jbocinsky/PortalTurret/Final Design Review.pdf

# EEL 4924 Senior Design

# Project: Glorious Freedom

# Team: Aperture Laboratories

## Submitted by:

## James Bocinsky (CE) and Mason Rawson (CE)

Abstract:

James Bocinsky and Mason Rawson, both CE majors, will be pairing up as a team to create an autonomous turret. The primary subsystems of the project will include a battery power supply, a camera, a central processing controller, and pan-tilt mounted nerf guns. The brain will use opencv with face detection to track an object’s motion. Software will calculate where and when to shoot nerf guns based on current object movement. We also have a manual override remote controller using wifi communication that allows a user to aim and shoot the turrets.

Features:

The overall goal of the glorious freedom sentry is to autonomously track an object and fire nerf guns at it. The project is inspired by the autonomous sentry turrets from the game “portal”, and the team will stick to this theme throughout the project. There will be one sentry (the overall shooting system) which has two turrets. Each turret has an independently controlled and aimed nerf gun.
The sentry will have two modes of operation, an autonomous mode and a manual mode. During autonomous mode, the sentry will be controlled by image processing via OpenCV. The image processing system, a raspberry pi 3 (pi), will use video input from our camera to the OpenCV library to pick out an object from a still background. The pi will then use SPI to send the objects pixel location to the main board. The main board will then translate the current object's location to motor positions for each turret. Once the position translation has been calculated, each turret will aim at the object and fire it’s nerf gun if the object is no longer moving.
During manual mode, the turret will be able to be controlled by a human using a separate controller. The controller will have input from buttons and a joystick. The joystick will control where the nerf guns point. Buttons will control commands and state. The button commands are shoot left nerf gun, shoot right nerf gun, shoot both nerf guns, reset aiming position, and toggle the mode of operation. The commands and joystick information will be sent to the main board on the sentry via a wifi module. Once the sentry has received the information it will operate as a user should expect; moving the sentries according to the joystick and firing the nerf guns according to a corresponding button press.

Technology Selection:

Our goal was to minimize mechanical work and custom electrical subsystems by using off-the-shelf parts. This would allow us to pursue advanced embedded computing with plenty of room to grow within the embedded computing.
To minimize mechanical and custom electrical work we took various steps. First we bought pan tilt mounts instead of 3D printed custom mounts. We will also use a USB camera to simplify this interface. The pi was chosen for video input as it was OpenCV friendly and powerful enough to handle the library. This allowed us to focus on the controls aspect of the project on the main board over configuring and setting up opencv on a raw barebones microcontroller. We took apart and used DC motors from an electric nerf gun instead of creating one from scratch. Our main board, using an msp432 and supporting an ESP8266, had very minimal analog components to allow us to focus on the controls and software aspects of the project. The controller board had an msp432 as well to keep things consistent across the project. It supported an ESP8266 as well for wifi communication, a joystick and buttons for human interactivity.
For software we utilized python for OpenCV, lua scripts for the ESP8266, C and C++ for our on board processing and controls. We used the openCV library, the most commonly used free computer vision software to assist in our face detection.
Technology: | Quantity:
Steppers and Drivers | 2
Metal Pan Tilt Mounts | 2
Nerf Guns | 2
Camera | 2
Raspberry Pi 3 | 1
Joystick | 1
Buttons | 6
ESP8266 NodeMCU Wifi Module | 2
MSP432 | 2

4.5V Battery Pack | 1
Lithium Polymer Battery 7.4V | 1
Portable USB Battery Charger | 1
6 Bullet Ammo Clip | 2
Voltage Regulator | 4
Buck Converter | 1
Various Resistors (see schematic for values) | x
Various Capacitors (see schematic for values) | x

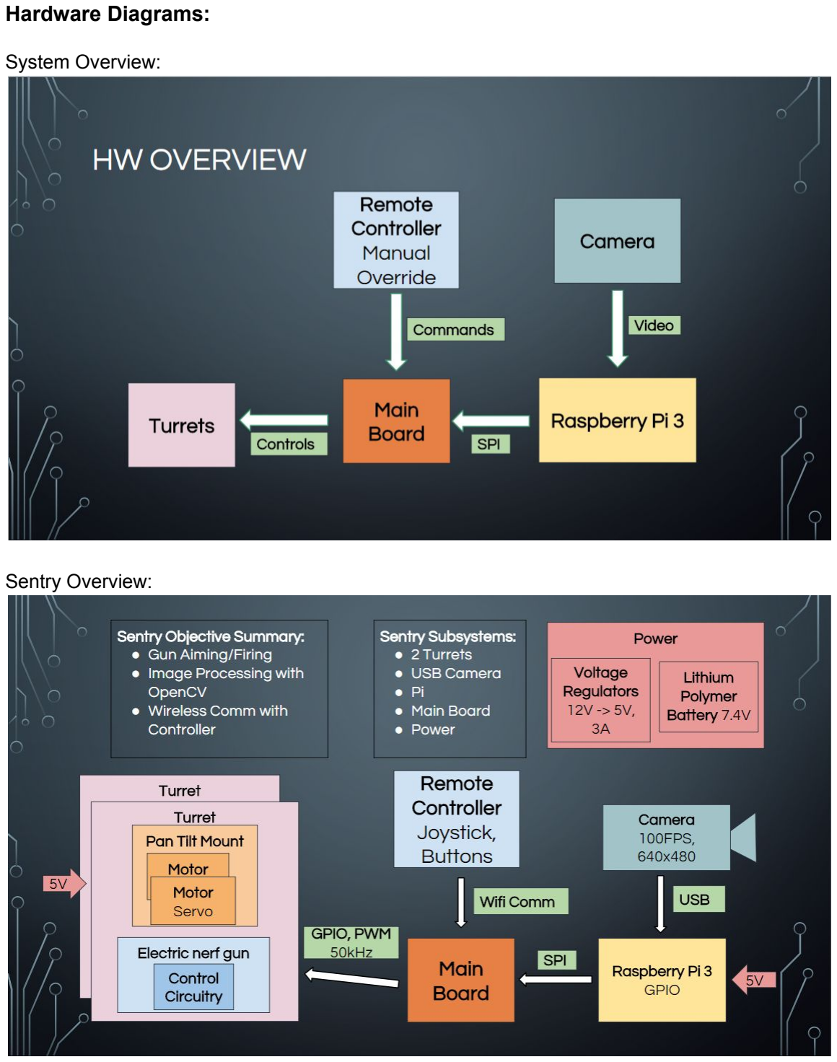
[picture p2: page 5]

Hardware Diagrams:

System Overview:

Sentry Overview:

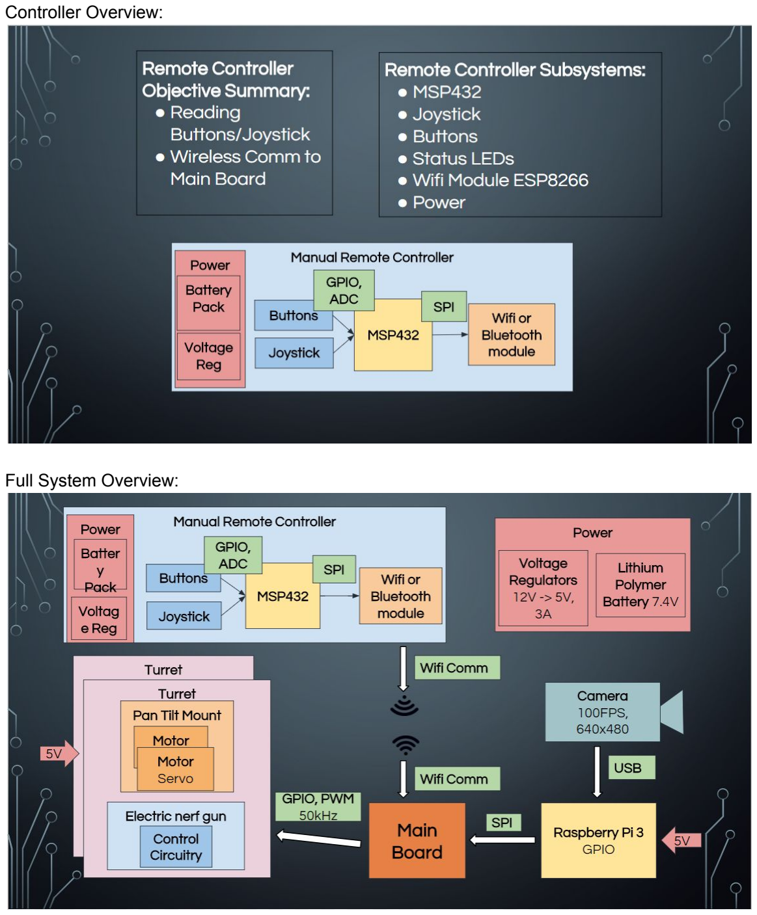
[picture p3: page 6]

Controller Overview:

Full System Overview:

Schematics:
Main Board:

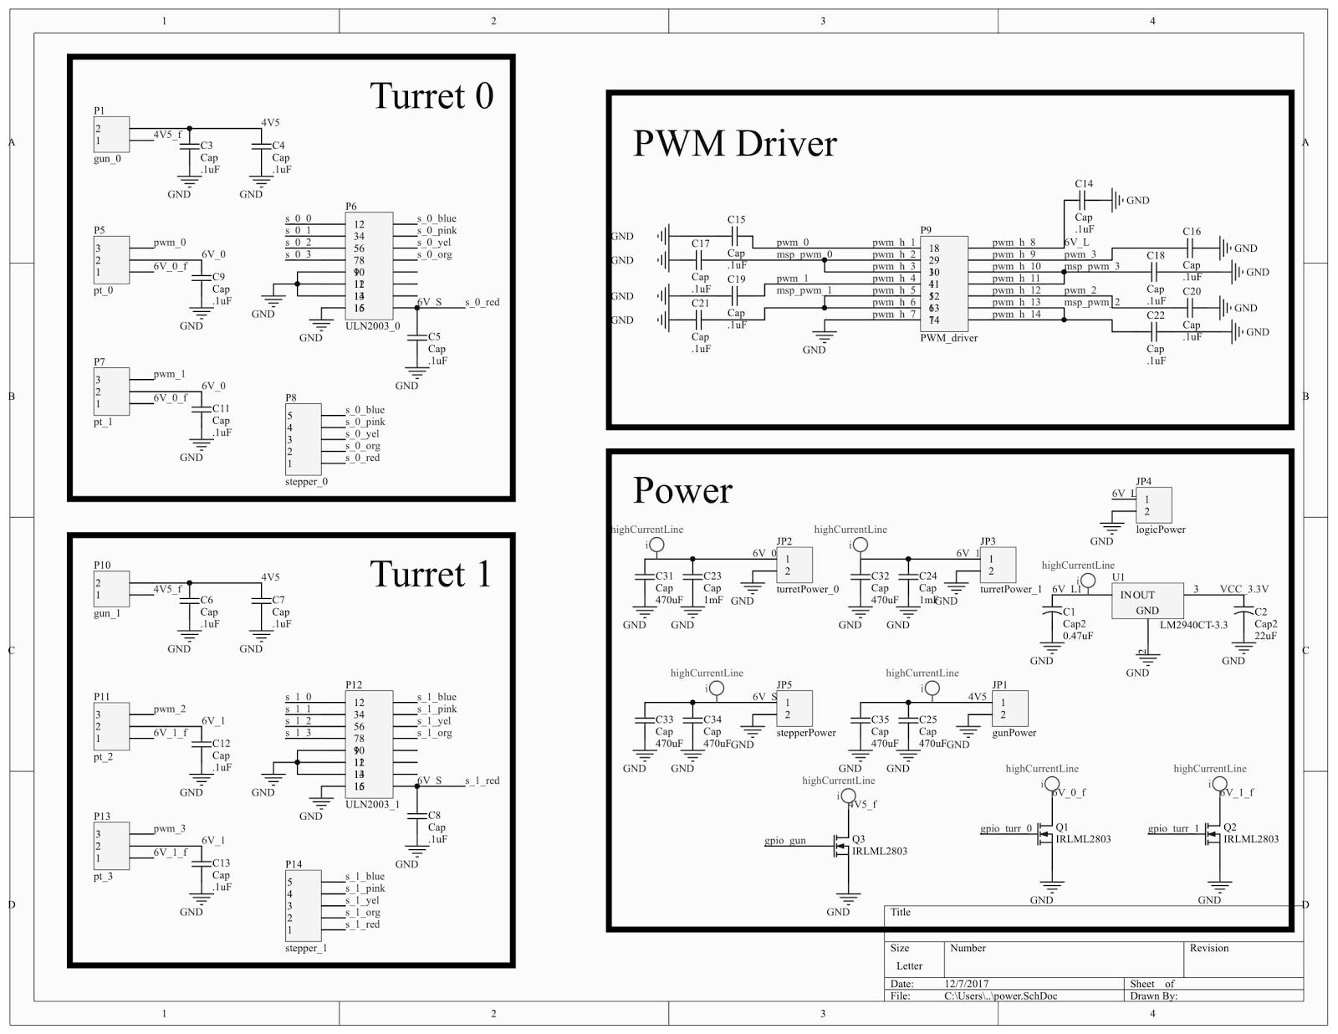
[picture p4: figure]

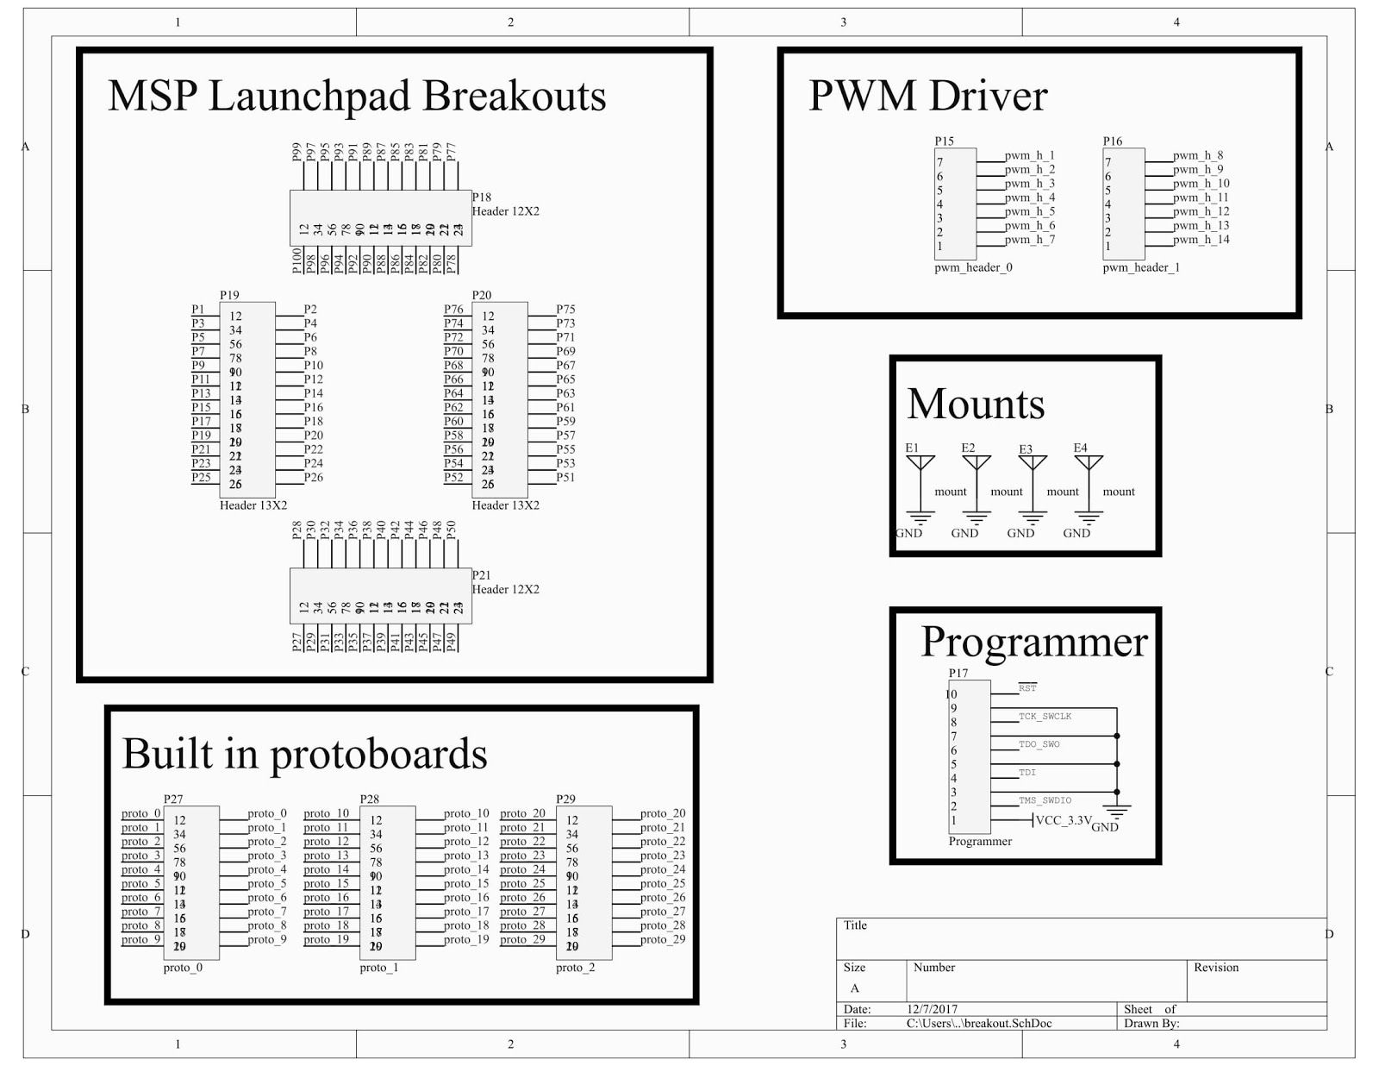
[picture p5: figure]

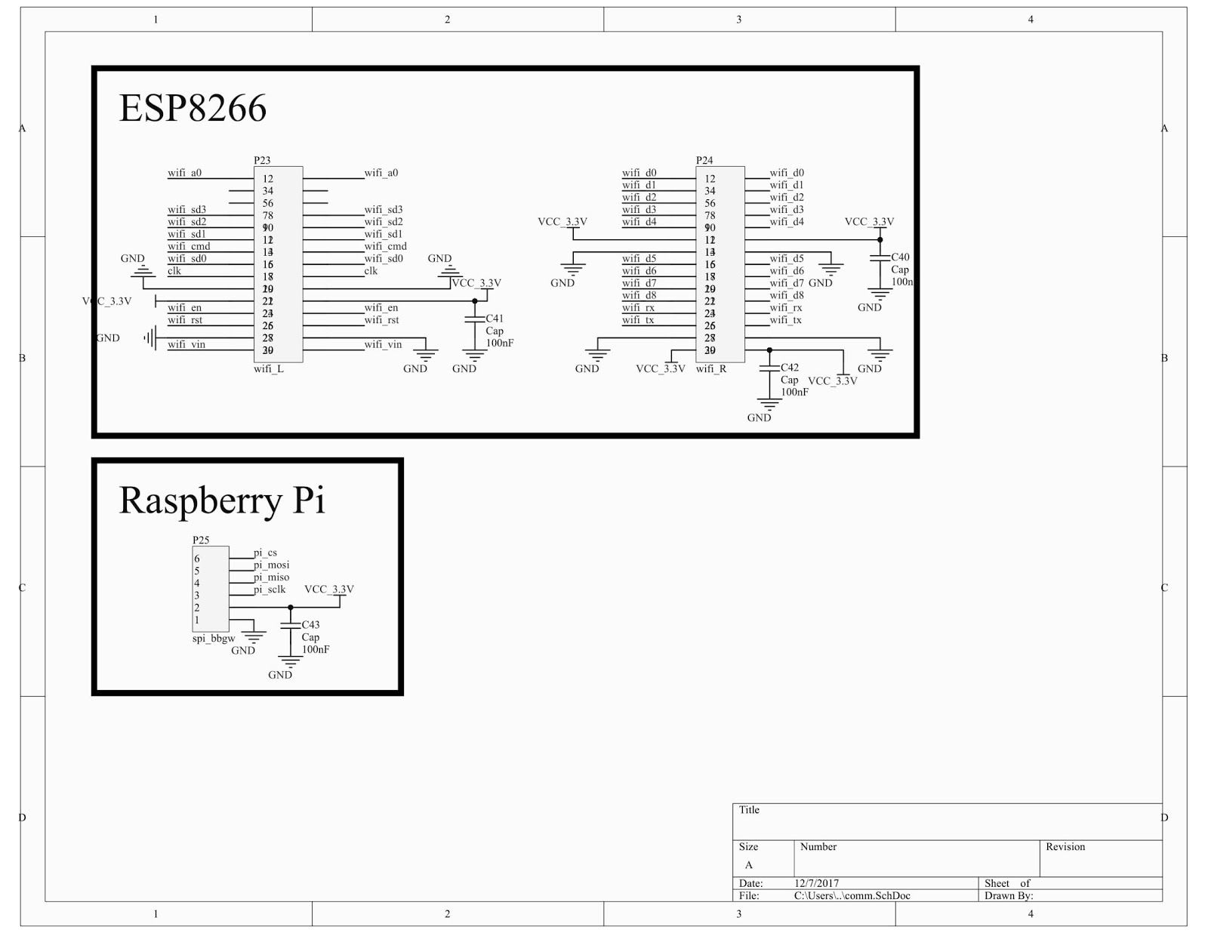
[picture p6: figure]

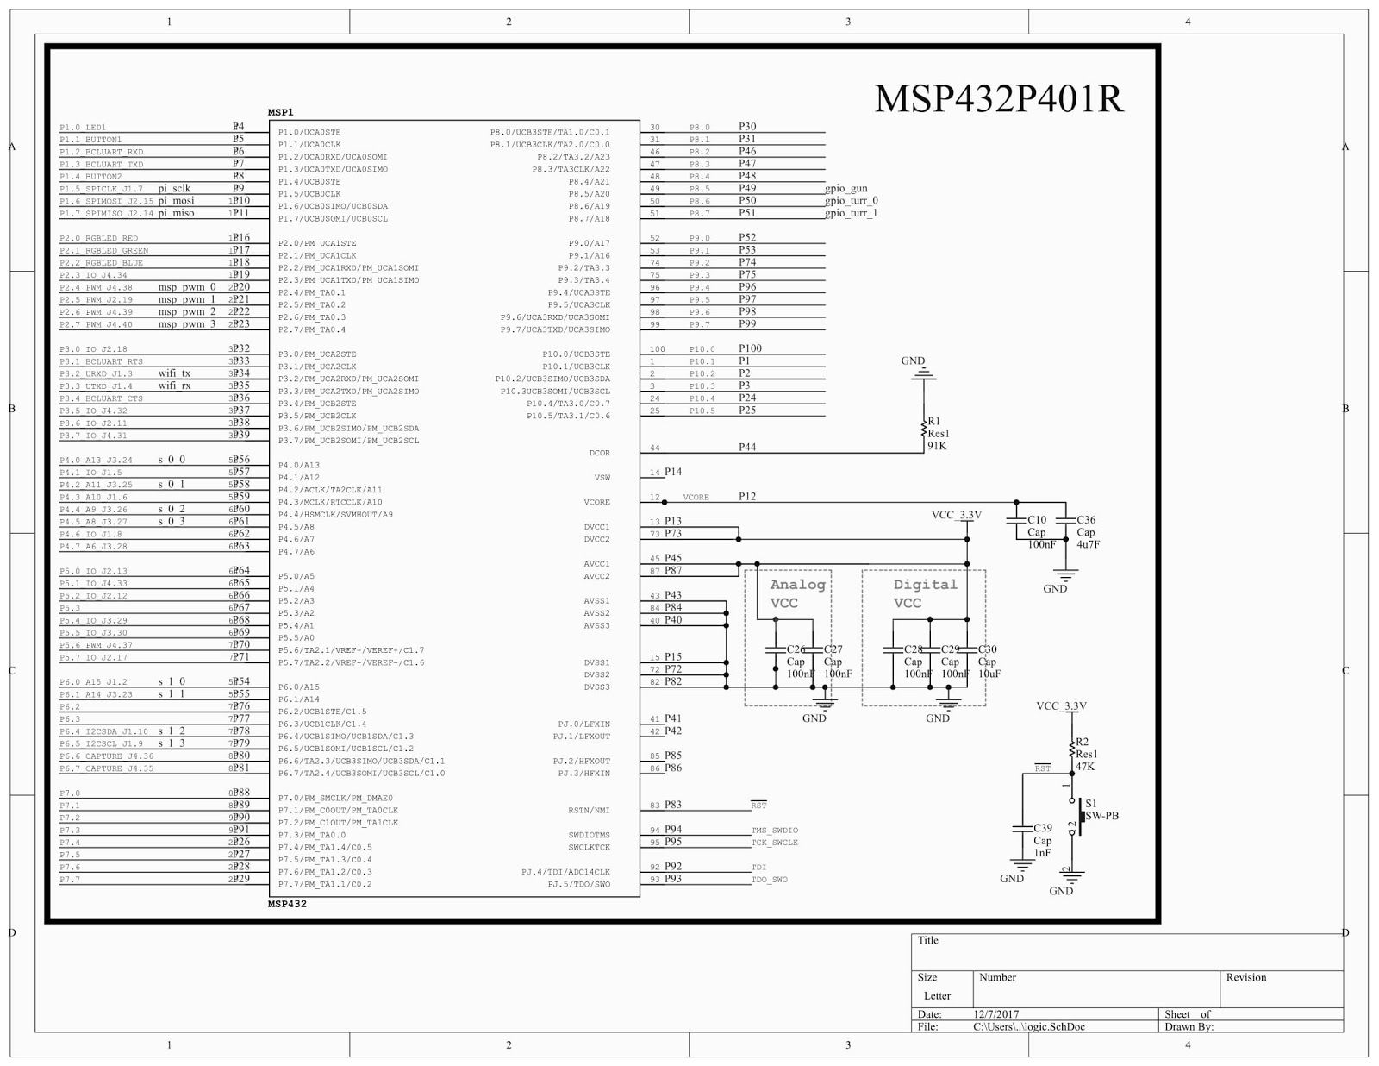
[picture p7: figure]

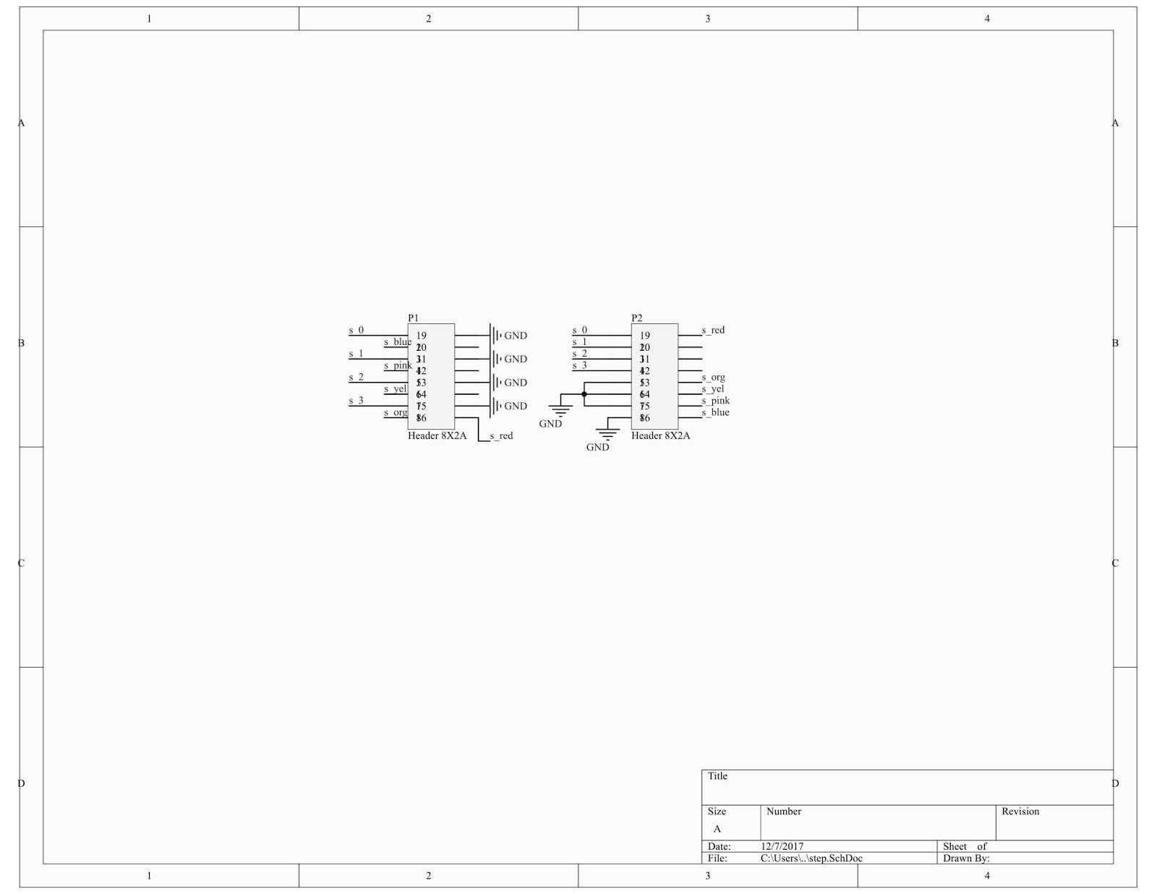
[picture p8: figure]

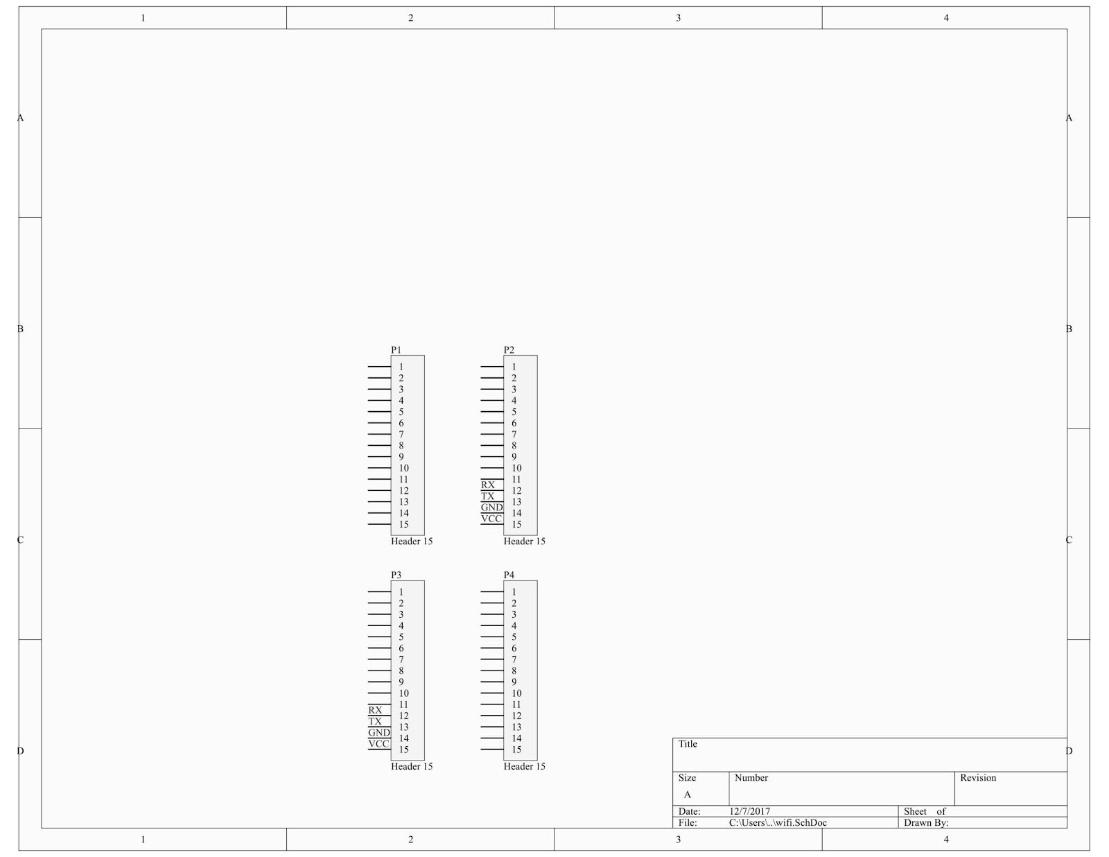
[picture p9: figure]

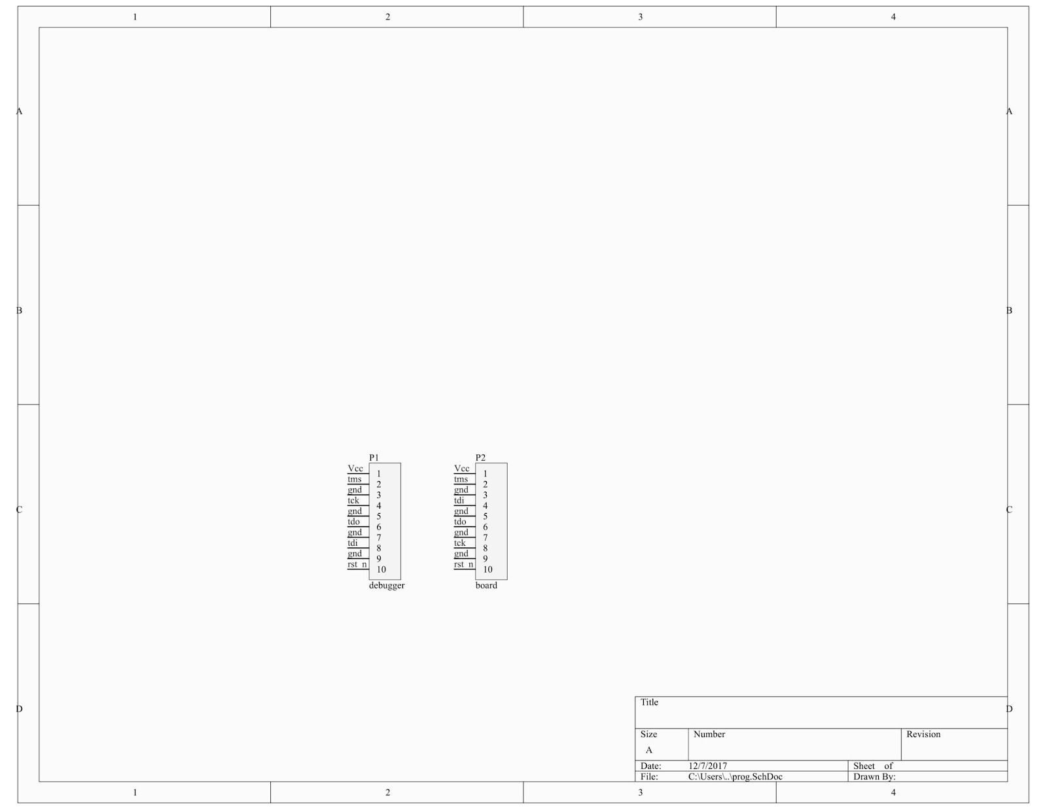
[picture p10: figure]

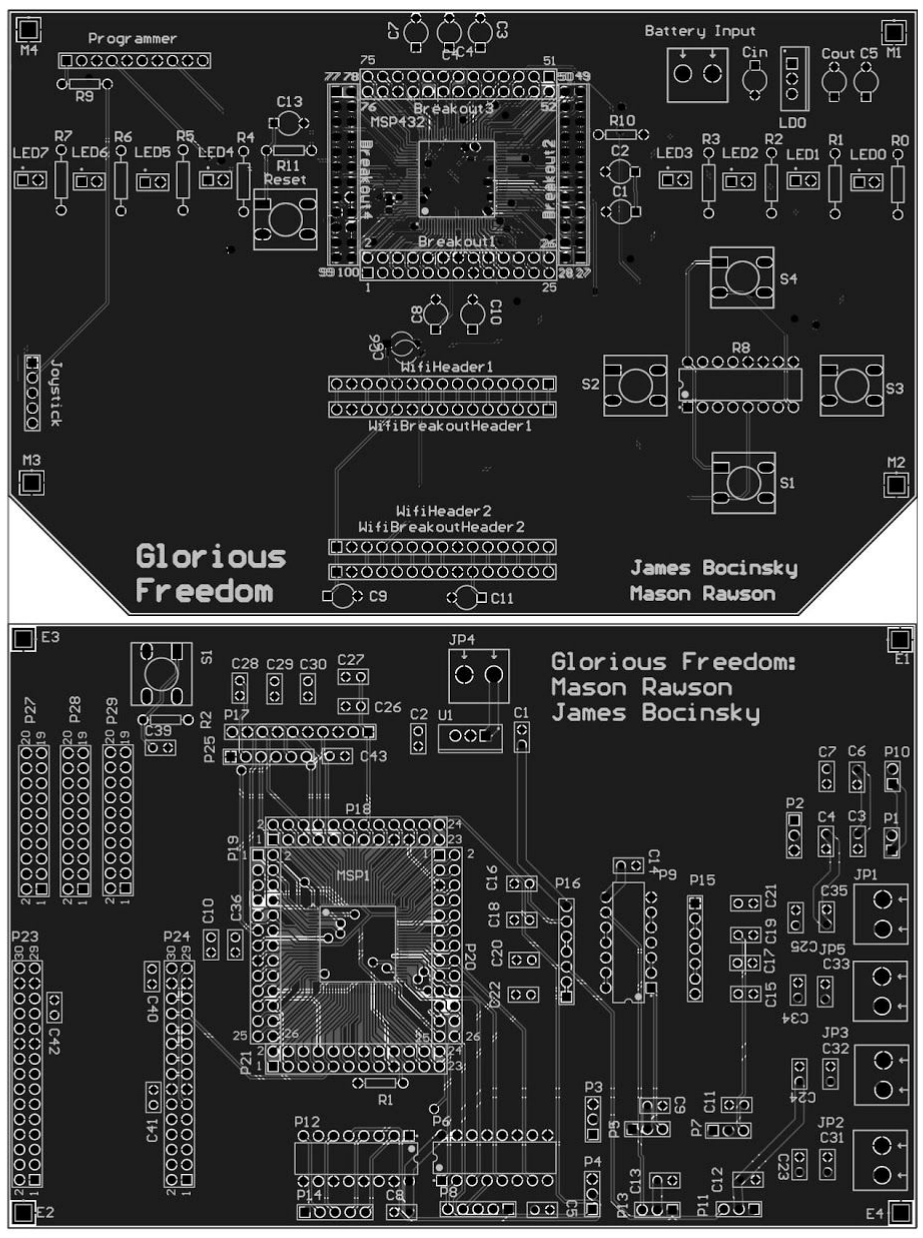
[picture p11: figure]

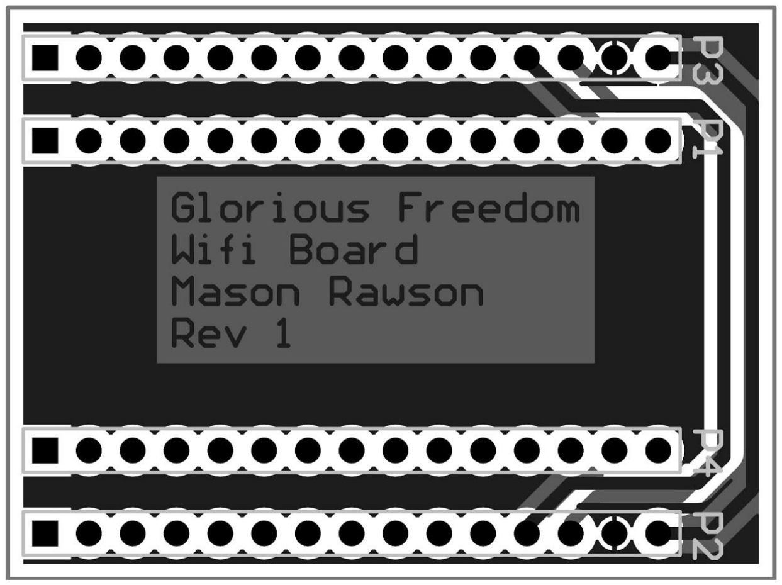
[picture p12: figure]
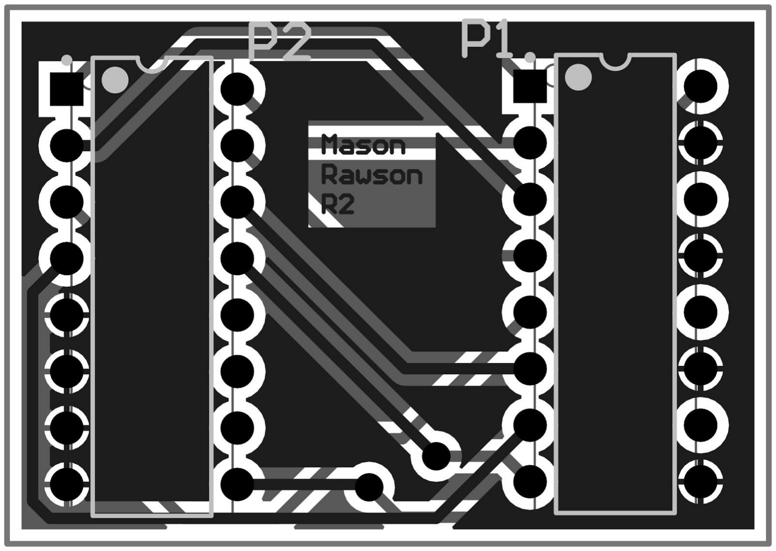
[picture p13: figure]
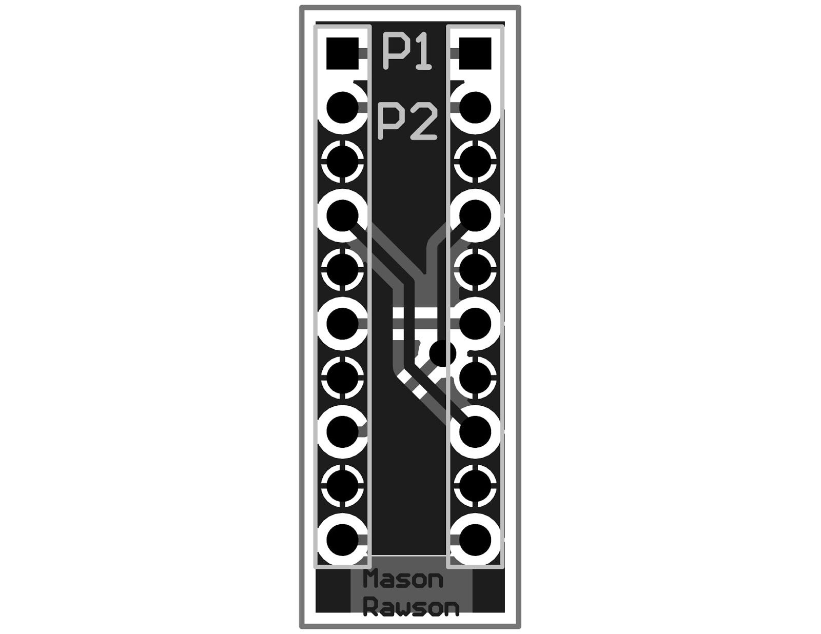
[picture p14: figure]

Controller:

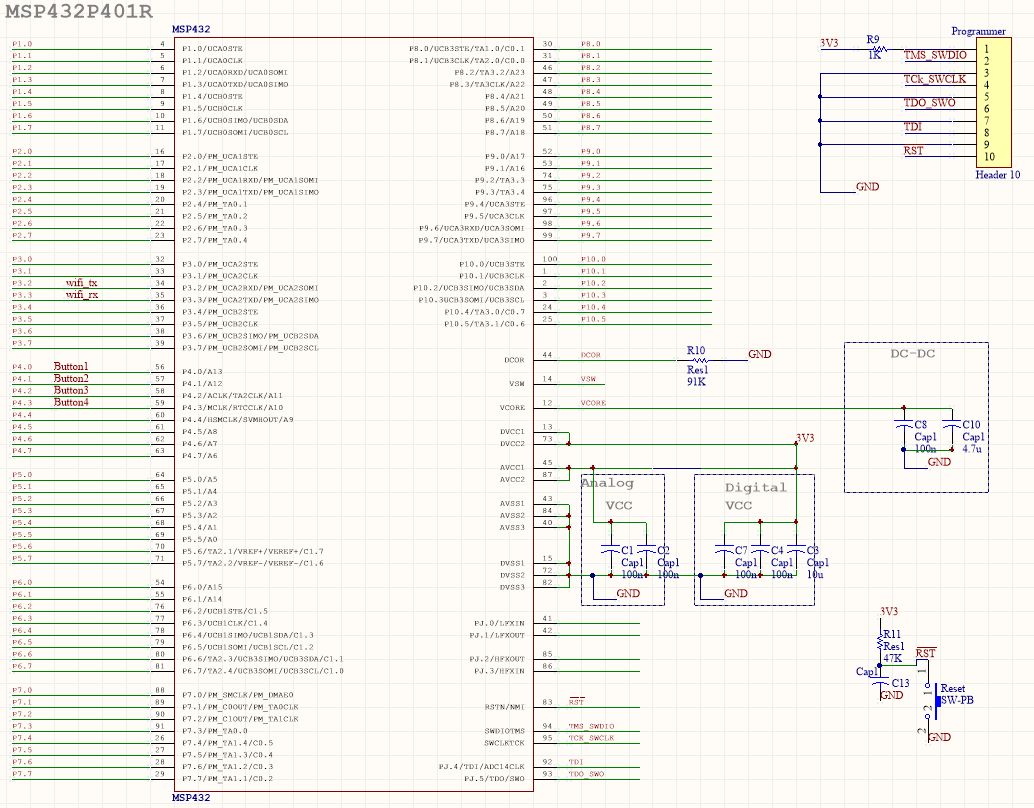
[picture p15: figure]

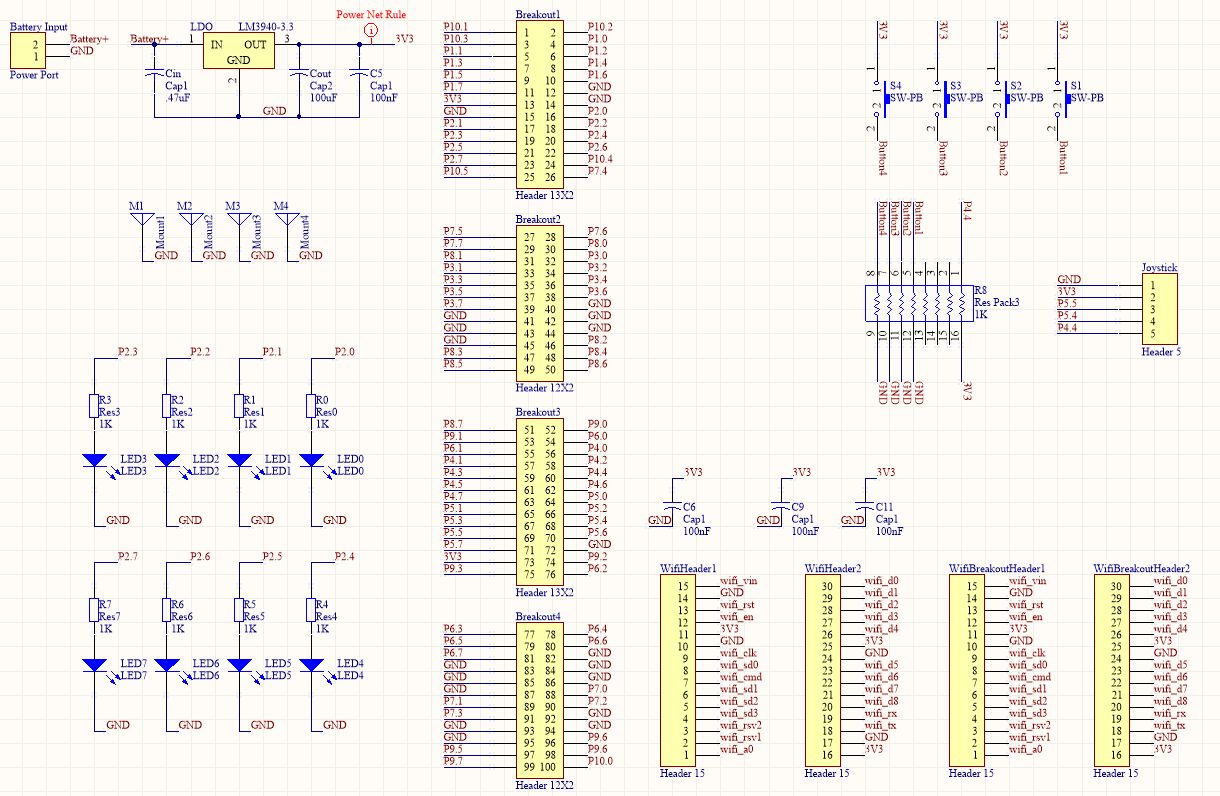
[picture p16: figure]
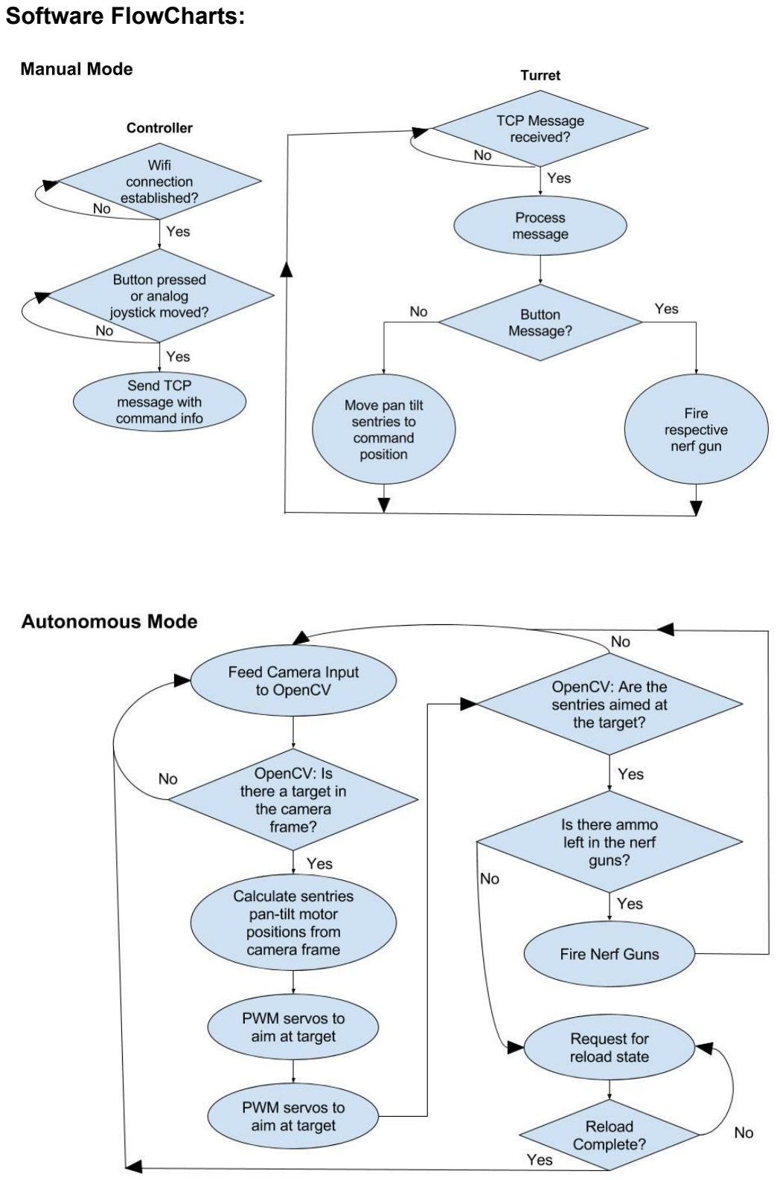
[picture p17: page 18]

Software FlowCharts:

Gantt Chart:

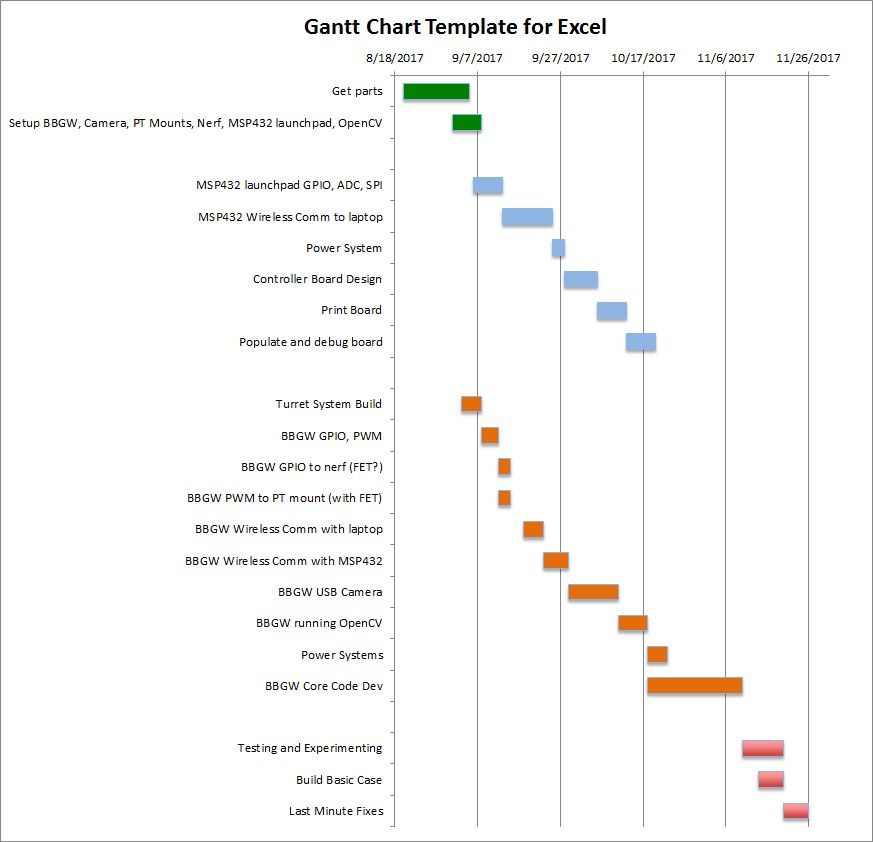
[picture p18: figure]

Individual | Responsibilities | & | Gantt | Chart | Breakdown:
Assignments: J = James, M = Mason, S = Shared

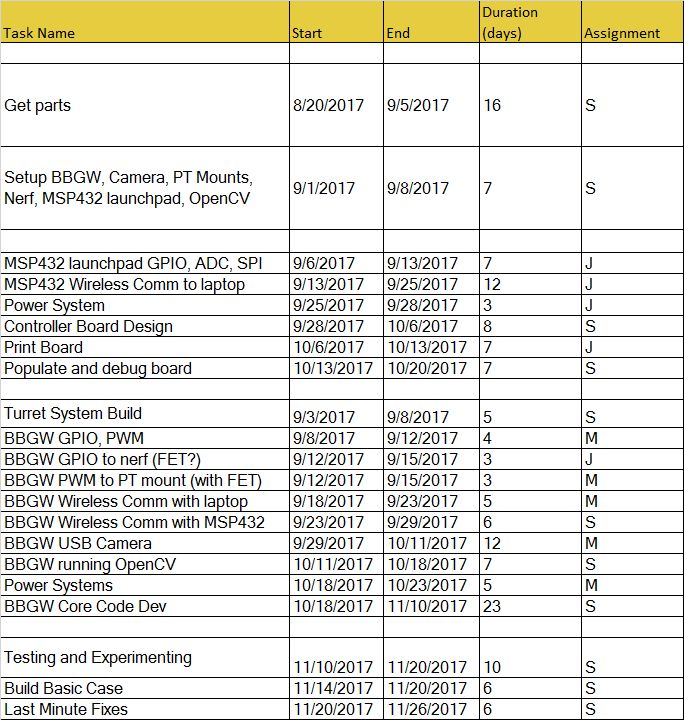
[picture p19: figure]

Engineering Solutions:

We needed to overcome many, many issues to be able to achieve our goal. I will highlight some of the most important ones here. The absolute worst error occurred at the end when we put everything together. The SPI communication from the Pi to the MSP would work for a random amount of time, and then turn to garbage. When it would become garbage was impossible to predict and seemingly impossible to recover from without a hardware reset. We later found that we could recover by shutting down the SPI peripheral and giving enough time delay before trying to re-initialize the system. We had never seen this before placing all parts inside our actual turret mount. We theorize that it is noise from the high power lines which run to the turret motors.
Another major problem was getting OpenCV to work on the Beaglebone. Unfortunately, the binaries which OpenCV relies on are incompatible with the Beaglebone. These error likely came from errors in cross compiling and simply went unnoticed in the Debian distribution since not many people run OpenCV on the beaglebone. Rather than investing significant effort in making it work on the beaglebone, we switched to a modern Raspberry Pi where OpenCV was fully supported. The major problems came with breadboard prototyping. High current spikes are very common in our design. They can happen so fast that when using a power supply, it is not obvious that a current limit was reached. This problem would lead to many many errors such as turning off the PWM drivers which would cause the servos to go haywire in addition to making the stepper motors simply not work. Additionally there was large amounts noise from the stepper wires running close to each other on the breadboard which had to be carefully bypassed out with capacitors.
Lastly we had various implementation details which lead to problems. For instance, the stepper motors didn’t have enough torque to push a bullet in the default bullet clip, so we removed the spring. The buck converter we chose for the turret motors would hit its current limit and magically act like a capacitor which was hard to identify. We now use a much larger buck converter. We melted traces, once on our power distribution board and twice on our stepper motor breakout boards. Two servo motors simply stopped working last minute. And finally, the main board had either routing errors or layout errors on most subsystems. The wifi chip pinouts were flipped. The wrong layout for the stepper motor drivers was used. We switched from using a chip to using fets for the PWM driver since multiple traces didn’t route. The programmer had two pins flipped because I followed outdated documentation. These and other issues plagued the project, but with a lot of hard work we were able to solve all of these problems.

Pictures:

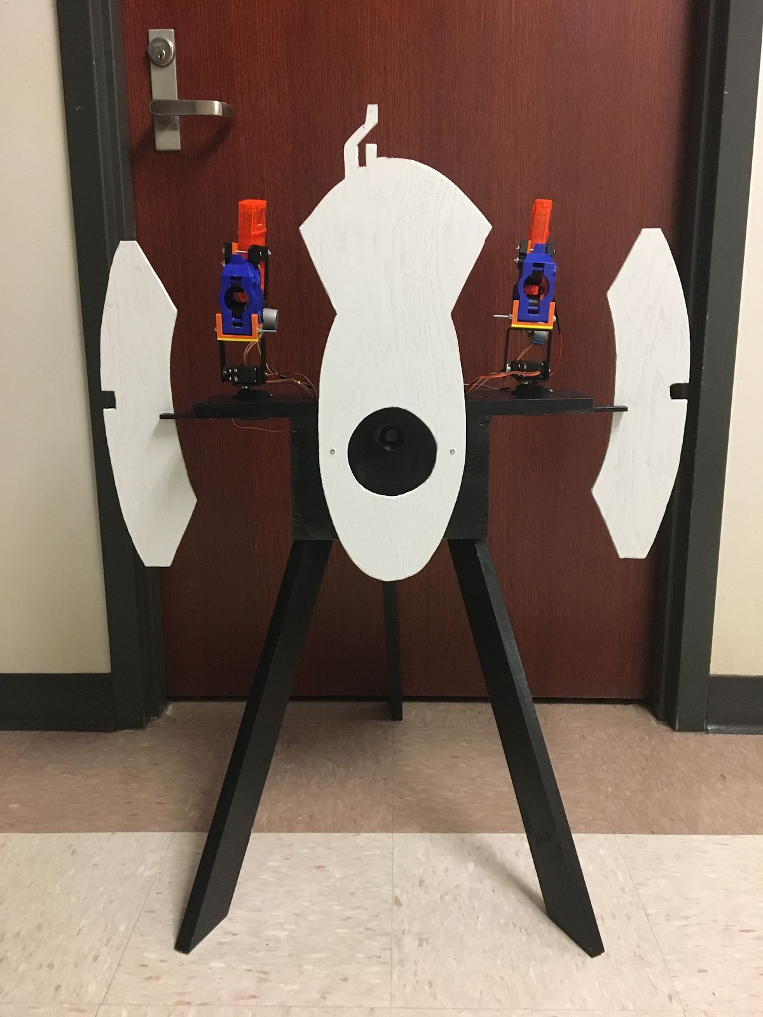
[picture p20: figure]
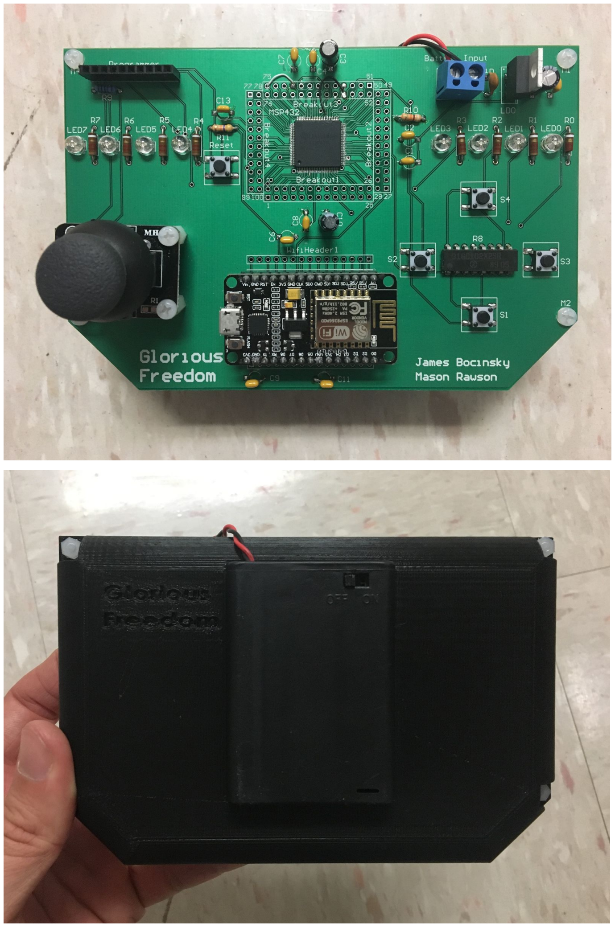
[picture p21: page 23]
