jbocinsky/PortalTurret/(list of files, drawings)

Other design files:
ctrlAltium/Controller.PcbDoc
ctrlAltium/Controller.SchDoc
ctrlAltium/msp432.SchDoc
mainAltium/breakout.SchDoc
mainAltium/comm.SchDoc
mainAltium/full.PcbDoc
mainAltium/logic.SchDoc
mainAltium/main.PcbDoc
mainAltium/main_2.PcbDoc
mainAltium/power.SchDoc
mainAltium/prog.PcbDoc
mainAltium/prog.SchDoc
mainAltium/step.PcbDoc
mainAltium/step.SchDoc
mainAltium/wifi.PcbDoc
mainAltium/wifi.SchDoc
